Zachary4672/GRO400H26-Saltimbanques/README.md

# Saltimbanques
bras robotique

La documentation est disponible dans les dossiers correspondant
