Zachary4672/GRO400H26-Saltimbanques/CAD/Decoupe/Base rotative - Boîte Side 2.dxf

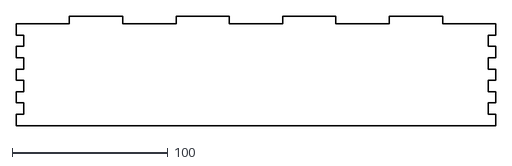
[picture p1: CAD file, 2026-04-19]
CAD/Decoupe/Base rotative - Boîte Side 2.dxf
308.0 x 70.0
