Zachary4672/GRO400H26-Saltimbanques/CAD/Impressions/J1.3mf

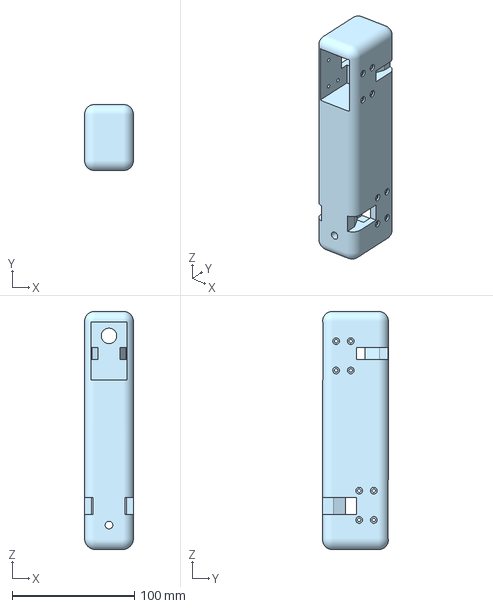
[picture p2: CAD file, 2026-04-19]
CAD/Impressions/J1.3mf
40.0 x 54.0 x 195.0 mm
