Zachary4672/GRO400H26-Saltimbanques/CAD/Pot de pillules - Part 1.step

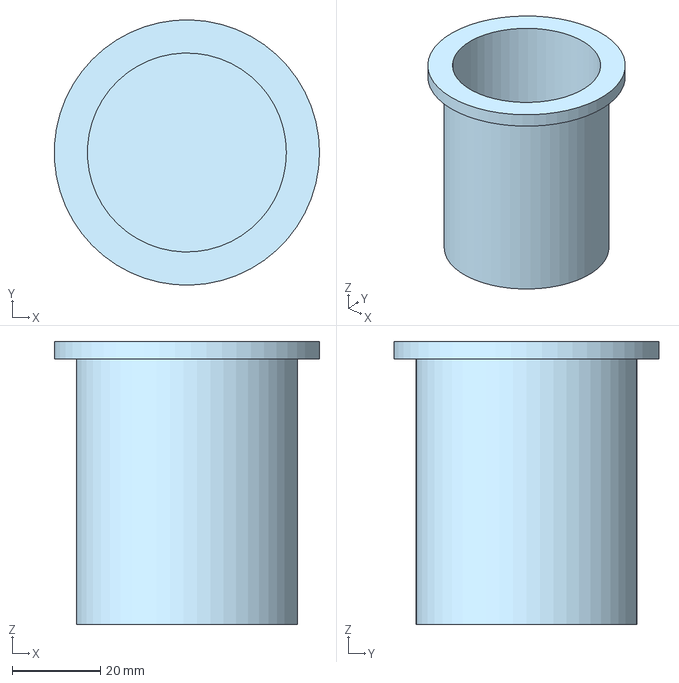
[picture p3: CAD file, 2026-04-19]
CAD/Pot de pillules - Part 1.step
59.9 x 60.0 x 64.0 mm
