Zachary4672/GRO400H26-Saltimbanques/CAD/Base rotative - Boite Top.step

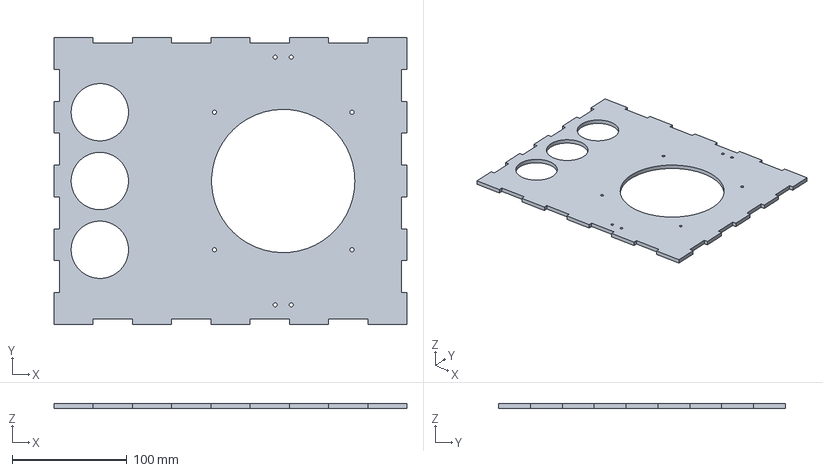
[picture p4: CAD file, 2026-04-19]
CAD/Base rotative - Boite Top.step
308.0 x 250.0 x 4.76 mm
