Zachary4672/GRO400H26-Saltimbanques/CAD/Decoupe/Base rotative - Boîte Side 1.dxf

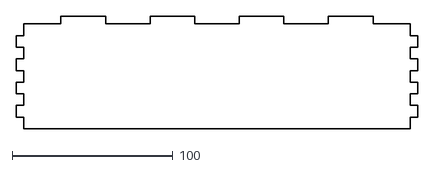
[picture p5: CAD file, 2026-04-19]
CAD/Decoupe/Base rotative - Boîte Side 1.dxf
250.0 x 70.0
