Zachary4672/GRO400H26-Saltimbanques/CAD/Axe Passif - Barre 1.step

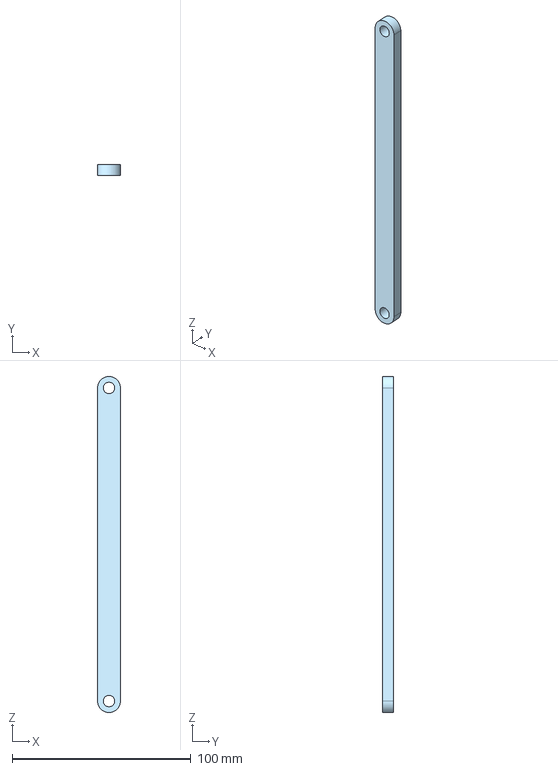
[picture p6: CAD file, 2026-04-19]
CAD/Axe Passif - Barre 1.step
12.8 x 6.00 x 187.8 mm
