Zachary4672/GRO400H26-Saltimbanques/CAD/Decoupe/Base rotative - Boite Top.dxf

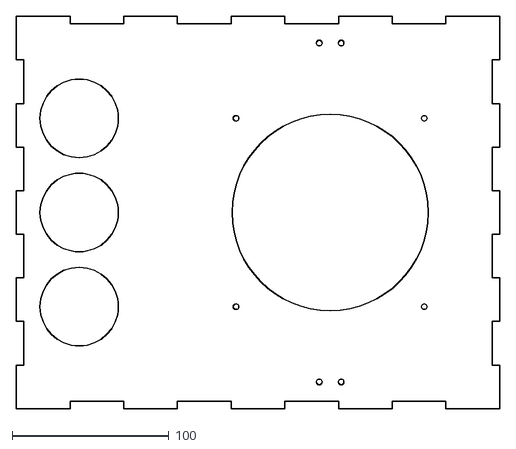
[picture p7: CAD file, 2026-04-19]
CAD/Decoupe/Base rotative - Boite Top.dxf
308.0 x 250.0
