Zachary4672/GRO400H26-Saltimbanques/CAD/Impressions/Poignet - Part 1.3mf

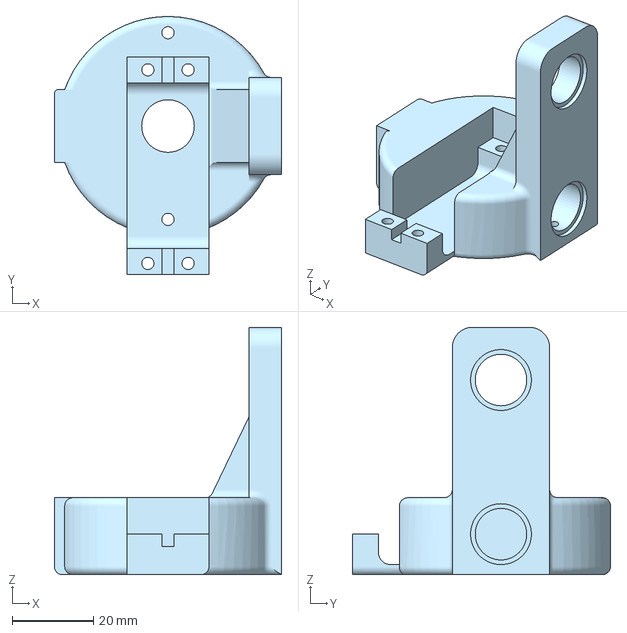
[picture p8: CAD file, 2026-04-19]
CAD/Impressions/Poignet - Part 1.3mf
56.0 x 63.6 x 61.0 mm
