Zachary4672/GRO400H26-Saltimbanques/CAD/Decoupe/Base rotative - Boîte Side 3.dxf

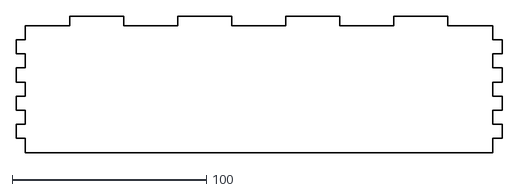
[picture p9: CAD file, 2026-04-19]
CAD/Decoupe/Base rotative - Boîte Side 3.dxf
250.0 x 70.0
