Zachary4672/GRO400H26-Saltimbanques/CAD/Impressions/Axe Passif - Barre 2.3mf

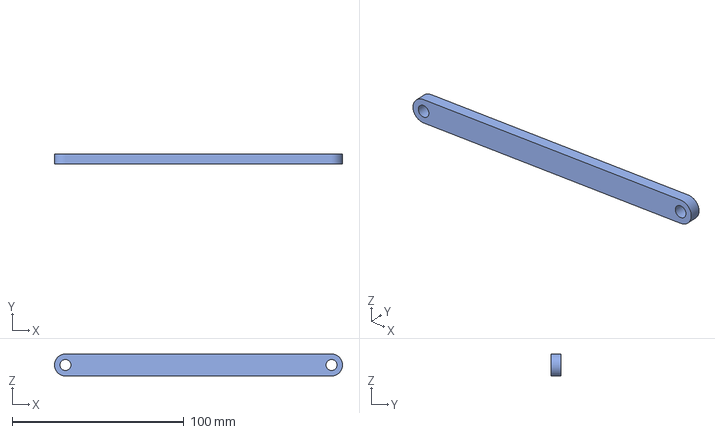
[picture p10: CAD file, 2026-04-19]
CAD/Impressions/Axe Passif - Barre 2.3mf
167.8 x 6.00 x 12.8 mm
