Zachary4672/GRO400H26-Saltimbanques/CAD/Nouveau gripper - base_pince2.step

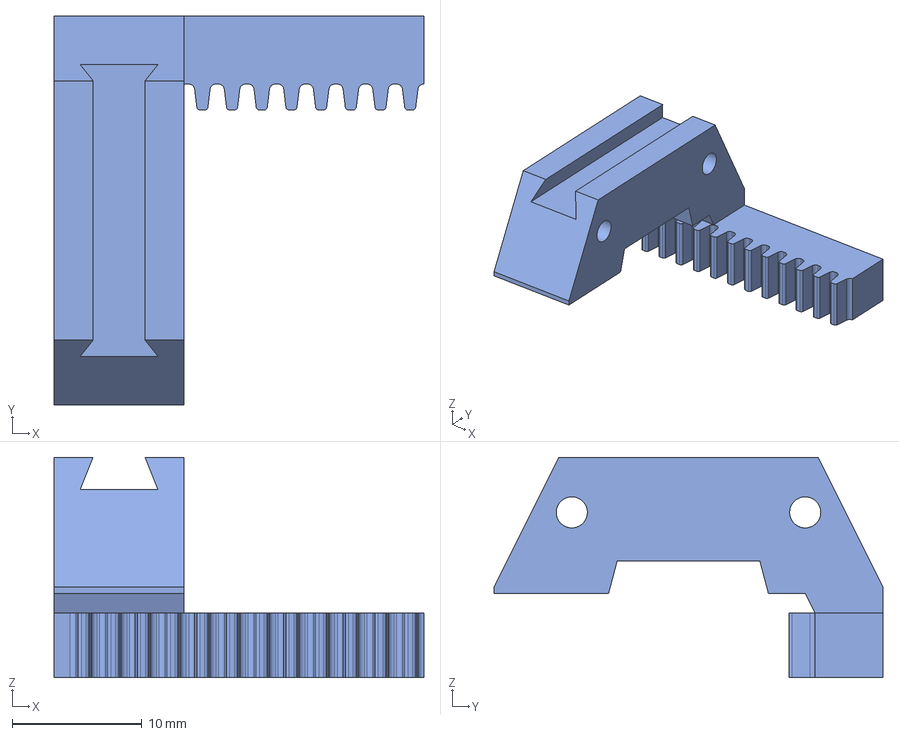
[picture p11: CAD file, 2026-04-19]
CAD/Nouveau gripper - base_pince2.step
28.5 x 30.0 x 17.0 mm
