Zachary4672/GRO400H26-Saltimbanques/CAD/Axe Passif - Triangle.step

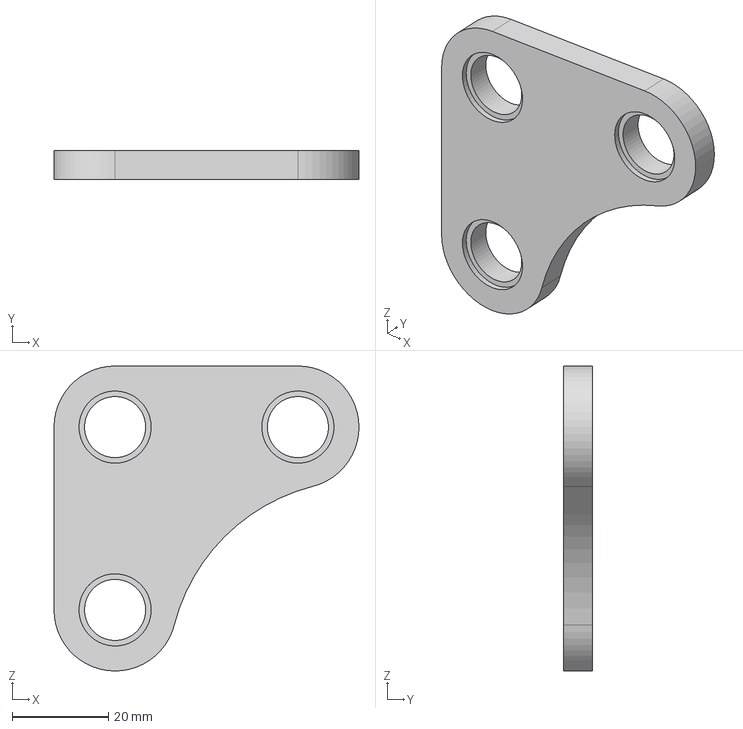
[picture p12: CAD file, 2026-04-19]
CAD/Axe Passif - Triangle.step
63.4 x 6.00 x 63.4 mm
