Zachary4672/GRO400H26-Saltimbanques/CAD/Decoupe/Base rotative - Boîte Side 4.dxf

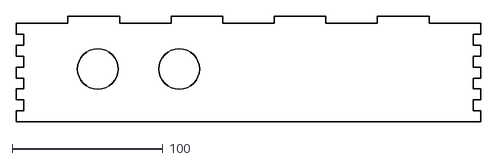
[picture p13: CAD file, 2026-04-19]
CAD/Decoupe/Base rotative - Boîte Side 4.dxf
308.0 x 70.0
