Zachary4672/GRO400H26-Saltimbanques/CAD/Impressions/Base rotative - Anneau Extérieur.3mf

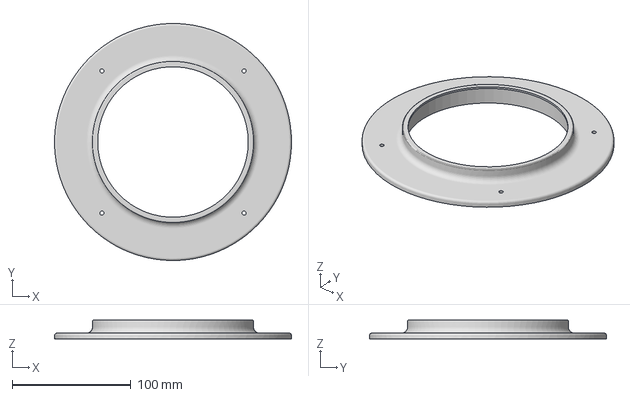
[picture p14: CAD file, 2026-04-19]
CAD/Impressions/Base rotative - Anneau Extérieur.3mf
200.0 x 200.0 x 16.0 mm
