Zachary4672/GRO400H26-Saltimbanques/CAD/Impressions/Nouveau gripper - Part 7.3mf

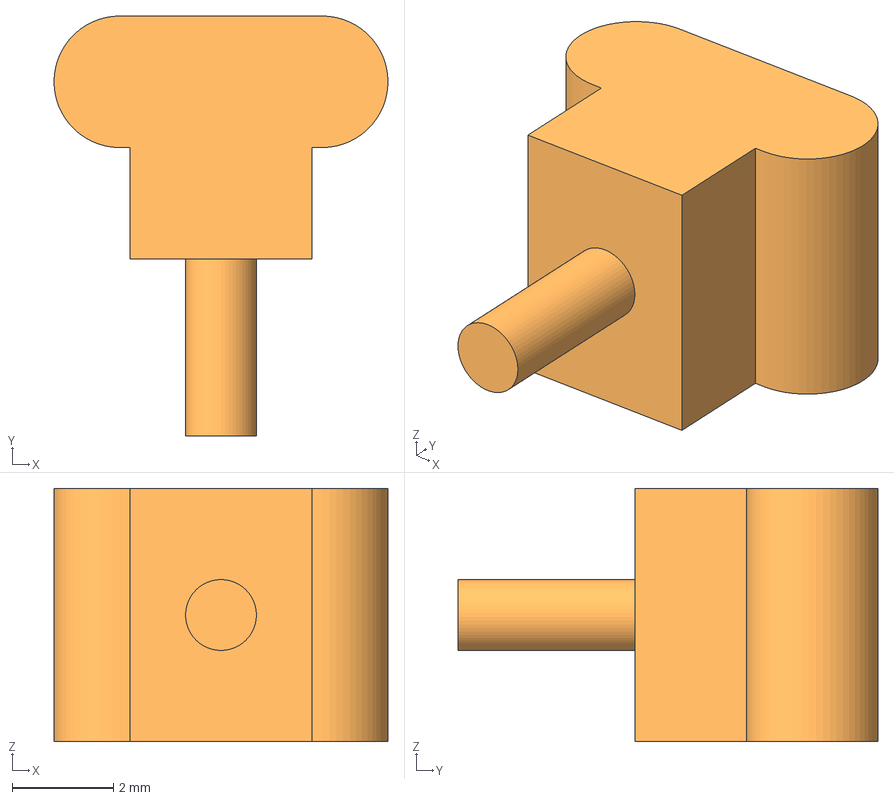
[picture p15: CAD file, 2026-04-19]
CAD/Impressions/Nouveau gripper - Part 7.3mf
6.60 x 8.30 x 5.00 mm
