Zachary4672/GRO400H26-Saltimbanques/CAD/Nouveau gripper - roue_vide.step

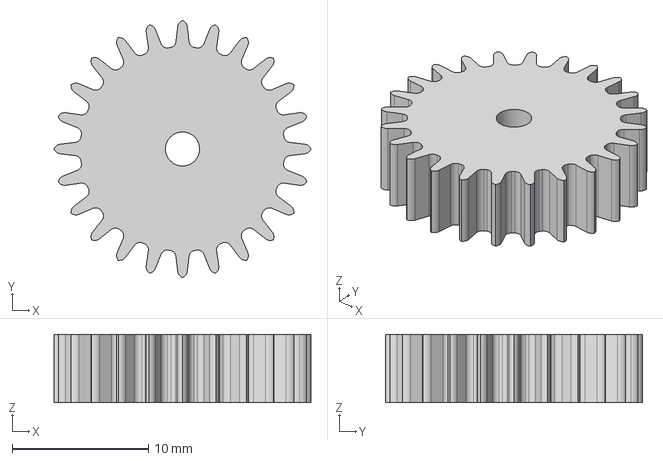
[picture p16: CAD file, 2026-04-19]
CAD/Nouveau gripper - roue_vide.step
18.9 x 18.9 x 5.00 mm
