Zachary4672/GRO400H26-Saltimbanques/CAD/attache.step

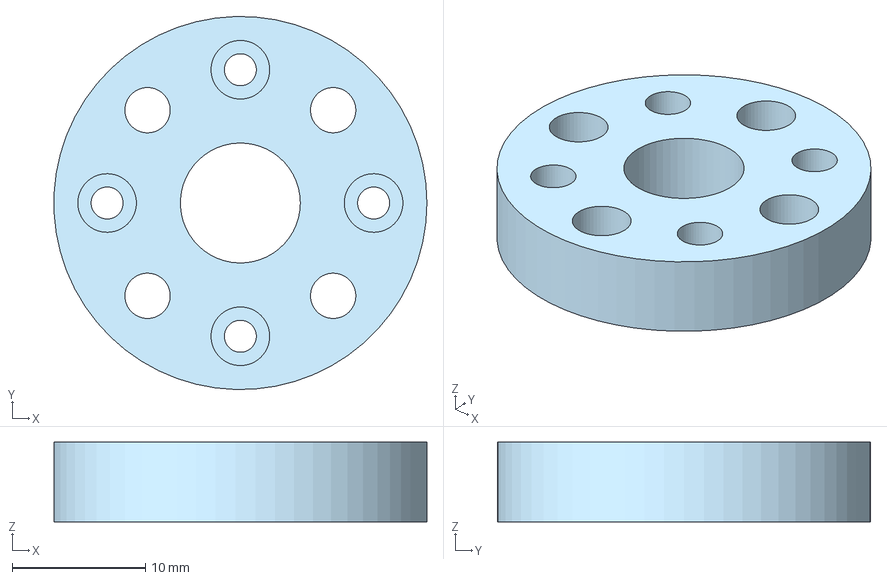
[picture p17: CAD file, 2026-04-19]
CAD/attache.step
28.0 x 28.0 x 6.00 mm
