Zachary4672/GRO400H26-Saltimbanques/CAD/Impressions/Nouveau gripper - fixation roue.3mf

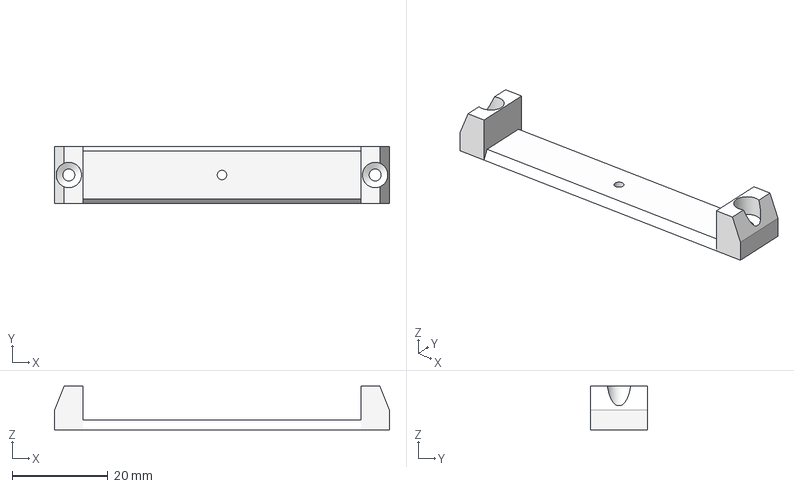
[picture p18: CAD file, 2026-04-19]
CAD/Impressions/Nouveau gripper - fixation roue.3mf
70.0 x 12.0 x 9.10 mm
