Zachary4672/GRO400H26-Saltimbanques/CAD/Impressions/Base rotative - Joint 0.3mf

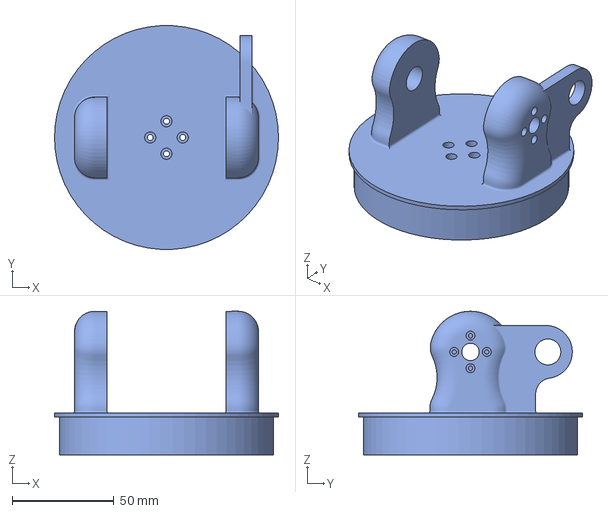
[picture p19: CAD file, 2026-04-19]
CAD/Impressions/Base rotative - Joint 0.3mf
110.0 x 109.8 x 70.5 mm
