Zachary4672/GRO400H26-Saltimbanques/CAD/Nouveau gripper - Part 9.step

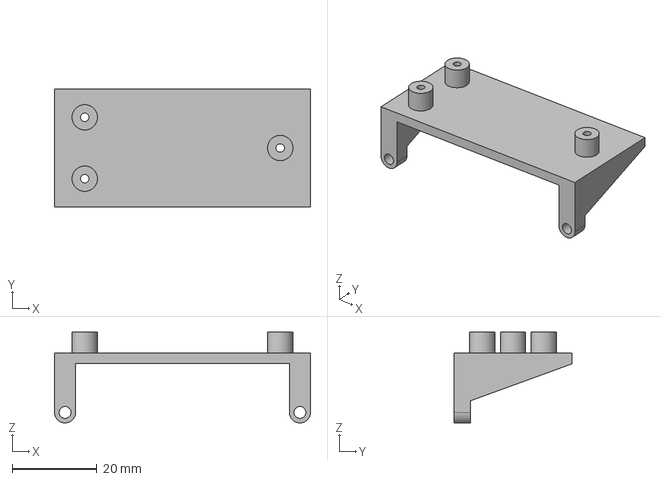
[picture p20: CAD file, 2026-04-19]
CAD/Nouveau gripper - Part 9.step
60.5 x 28.0 x 21.5 mm
