Zachary4672/GRO400H26-Saltimbanques/CAD/Impressions/Poignet - Part 2.3mf

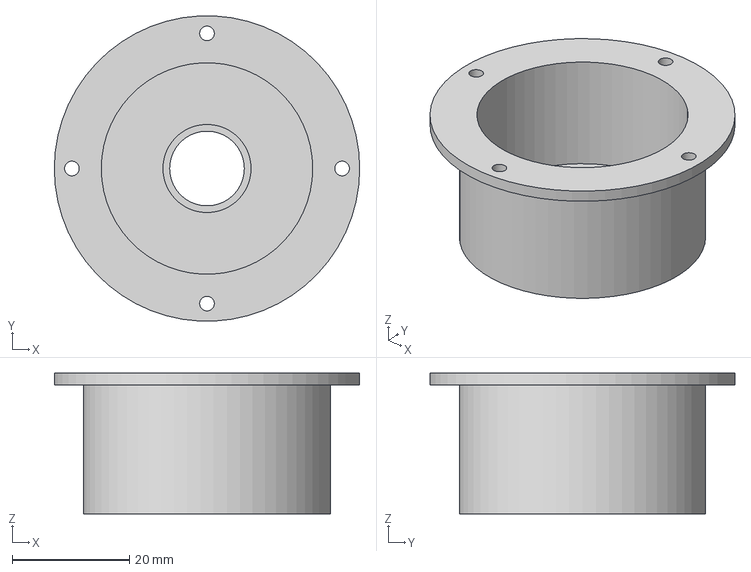
[picture p21: CAD file, 2026-04-19]
CAD/Impressions/Poignet - Part 2.3mf
52.0 x 51.9 x 24.0 mm
