Zachary4672/GRO400H26-Saltimbanques/CAD/Base rotative - Support Moteur.step

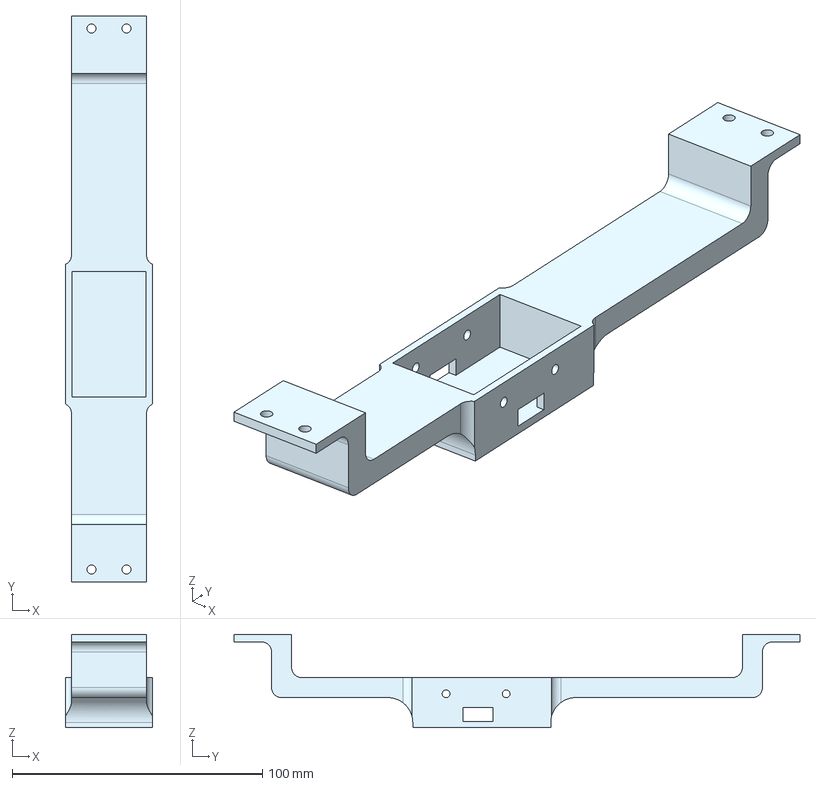
[picture p23: CAD file, 2026-04-19]
CAD/Base rotative - Support Moteur.step
34.6 x 226.0 x 37.2 mm
