Zachary4672/GRO400H26-Saltimbanques/CAD/Impressions/Nouveau gripper - base_pince1.3mf

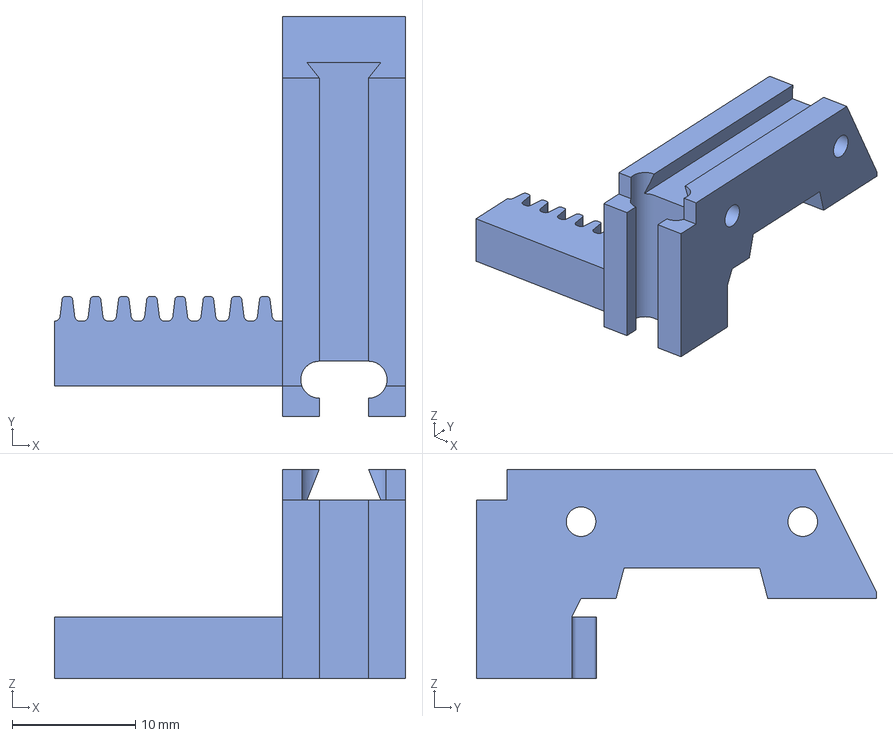
[picture p24: CAD file, 2026-04-19]
CAD/Impressions/Nouveau gripper - base_pince1.3mf
28.5 x 32.5 x 17.0 mm
