Zachary4672/GRO400H26-Saltimbanques/CAD/Impressions/Nouveau gripper - base_pince2.3mf

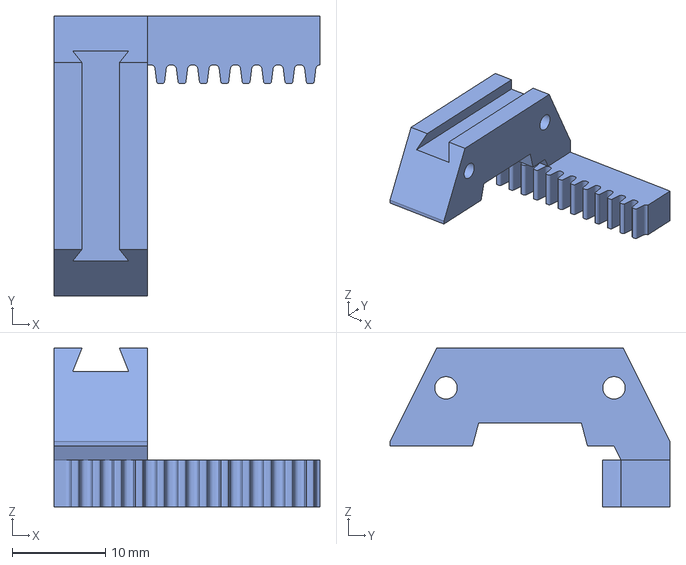
[picture p25: CAD file, 2026-04-19]
CAD/Impressions/Nouveau gripper - base_pince2.3mf
28.5 x 30.0 x 17.0 mm
