Zachary4672/GRO400H26-Saltimbanques/CAD/Impressions/Nouveau gripper - boîte 1.3mf

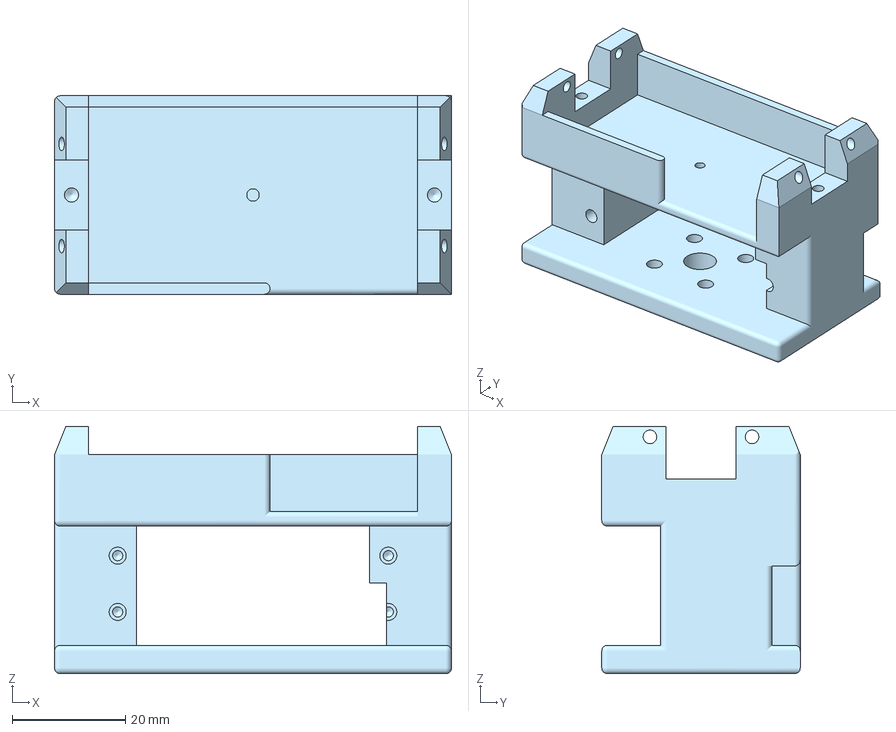
[picture p26: CAD file, 2026-04-19]
CAD/Impressions/Nouveau gripper - boîte 1.3mf
70.0 x 35.0 x 43.6 mm
