Zachary4672/GRO400H26-Saltimbanques/CAD/Base rotative - Boîte Side 3.step

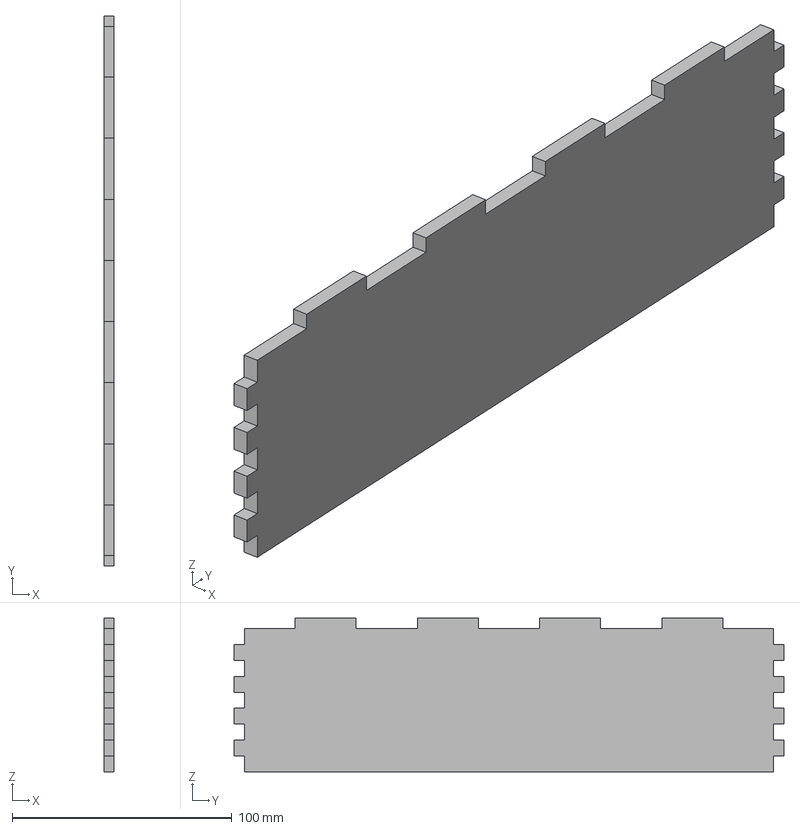
[picture p27: CAD file, 2026-04-19]
CAD/Base rotative - Boîte Side 3.step
4.76 x 250.0 x 70.0 mm
