Zachary4672/GRO400H26-Saltimbanques/CAD/Impressions/J2.3mf

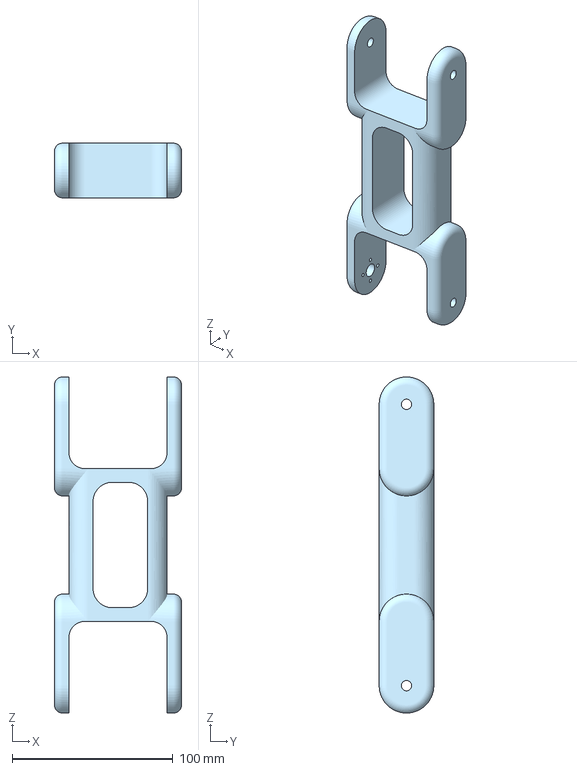
[picture p28: CAD file, 2026-04-19]
CAD/Impressions/J2.3mf
79.0 x 34.0 x 209.0 mm
