Zachary4672/GRO400H26-Saltimbanques/CAD/Impressions/Nouveau gripper - Pince_1.3mf

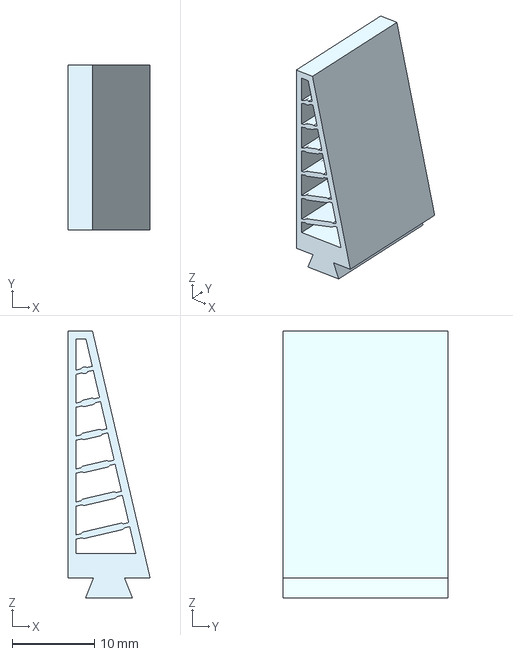
[picture p29: CAD file, 2026-04-19]
CAD/Impressions/Nouveau gripper - Pince_1.3mf
10.0 x 20.0 x 32.4 mm
