Zachary4672/GRO400H26-Saltimbanques/CAD/Base rotative - Boîte Side 2.step

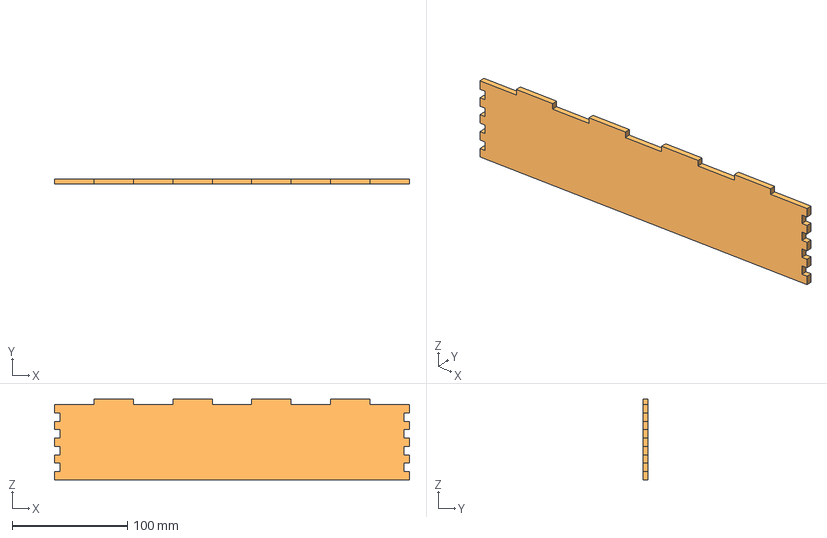
[picture p30: CAD file, 2026-04-19]
CAD/Base rotative - Boîte Side 2.step
308.0 x 4.76 x 70.0 mm
