Zachary4672/GRO400H26-Saltimbanques/CAD/Nouveau gripper - base_pince1.step

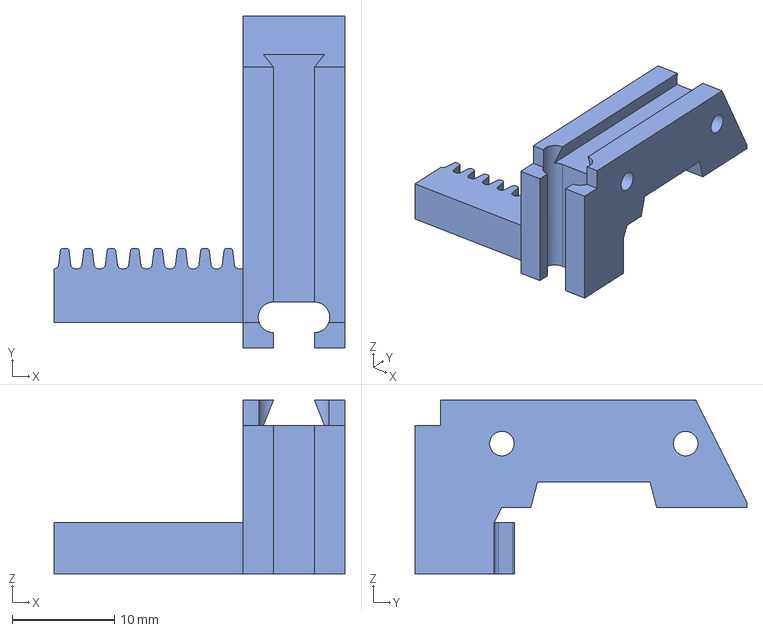
[picture p31: CAD file, 2026-04-19]
CAD/Nouveau gripper - base_pince1.step
28.5 x 32.5 x 17.0 mm
