Zachary4672/GRO400H26-Saltimbanques/CAD/Base rotative - Bearing.step

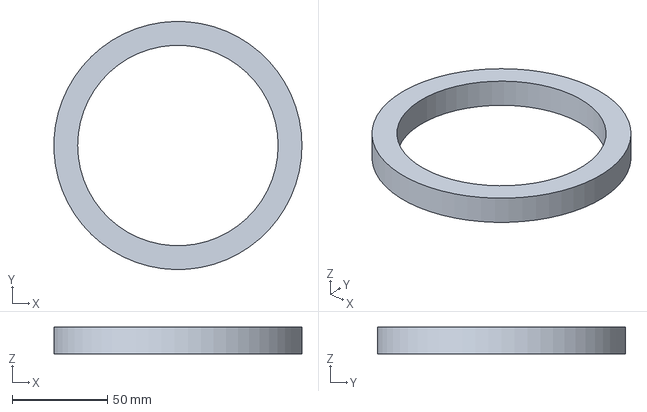
[picture p32: CAD file, 2026-04-19]
CAD/Base rotative - Bearing.step
129.9 x 130.0 x 14.0 mm
