Zachary4672/GRO400H26-Saltimbanques/CAD/Nouveau gripper - Roue dentée.step

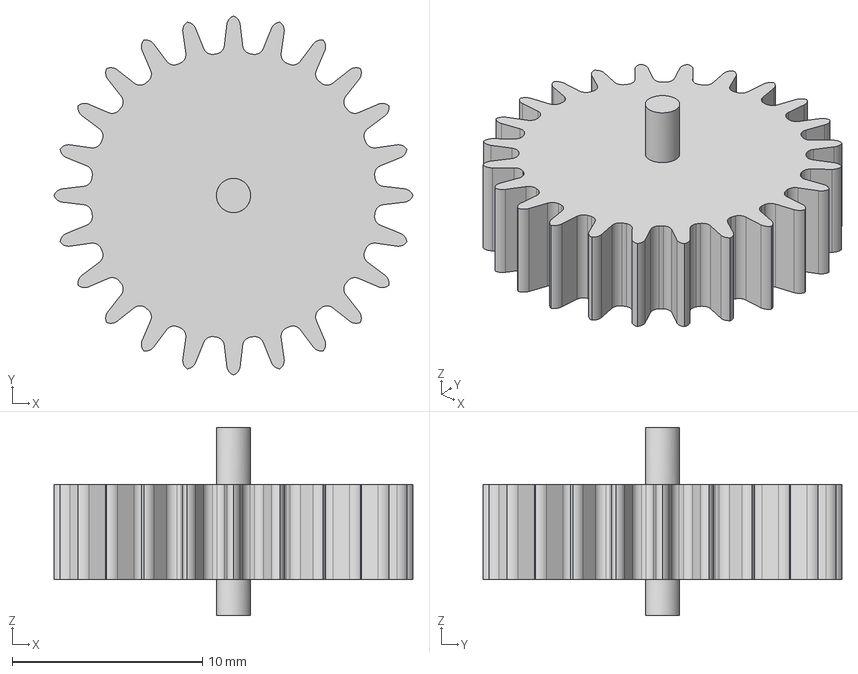
[picture p33: CAD file, 2026-04-19]
CAD/Nouveau gripper - Roue dentée.step
18.9 x 18.9 x 9.90 mm
