Zachary4672/GRO400H26-Saltimbanques/(list of files, cad)

Other CAD files:
CAD/Impressions/Pot de pillules.3mf
CAD/Axe Passif - Barre 2.step
CAD/Impressions/Nouveau gripper - roue_vide.3mf
CAD/Impressions/Axe Passif - Triangle.3mf
CAD/Nouveau gripper - Part 7.step
CAD/Base rotative - Anneau Extérieur.step
CAD/Impressions/attache - Part 1.3mf
CAD/Base rotative - Joint 0.step
CAD/Nouveau gripper - fixation roue.step
CAD/Nouveau gripper - boîte 1.step
CAD/Nouveau gripper - Pince_1.step
CAD/J2.step
CAD/Poignet - Part 1.step
CAD/J1 - Part 1.step
CAD/Poignet - Part 2.step
CAD/Base rotative - Boîte Side 1.step
