Zachary4672/GRO400H26-Saltimbanques/HMI_INSTALL/README

La documentation est disponible dans l'onglet "Wiki" de ce github.
