Zachary4672/GRO400H26-Saltimbanques/(commit log)

2026-02-18 code moteur organiser plus le code pour contrôler le gripper
2026-02-20 petit changement pour les cas limite
2026-02-21 Add files via upload
    model de CV entrainé avec des Jellybean. Détecte encore certains faux positif lorsque l'image est flou, ou que l'objet est rond est saturé.
2026-02-23 Ajout des positions de JB
2026-02-24 sortie des positions
2026-04-01 Code et nouveau fichier pour calibration avec un échéquier.
2026-04-01 proche de version final
2026-04-01 Calibration semble bonne. Implémentation de l'image calibrée dans le traitement d'image
2026-04-08 Cinematique corrigée (test à suivre)
    [Tests.py, bras_robot.py, donnees.py, main.py]
2026-04-08 Problème de logique
2026-04-09 Modification du main pour les tests de demain
2026-04-09 Create CAD
    ddd
2026-04-09 Correction des angles
2026-04-09 fichier de calibration de la caméra
2026-04-09 changement de nom
2026-04-09 modification cinématique reste modifier (modifier des commentaires)
2026-04-11 Cleaning du code main.py et ajout du squelette pour l'ajout de la partie de contrôle venant du HMI
2026-04-12 pret pour le premier test camera et robot
2026-04-15 Revert "débug encore"
    This reverts commit e6407ce1372f0752042352ce09e92b26517165d9.
    [bras_robot.py, donnees.py, main.py]
2026-04-15 Commit
    commit
    [arduino_zero.cfg]
2026-04-16 nouvelle calibration
2026-04-16 correction calibration
2026-04-19 Refactor robot arm functions and improve comments
2026-04-19 Modif Mathis
    [Axe Passif - Barre 1.step, Axe Passif - Barre 2.3mf, Axe Passif - Barre 2.step, Axe Passif - Triangle.3mf, Axe Passif - Triangle.step, Base rotative - Anneau Extérieur.3mf, Base rotative - Anneau Extérieur.step, Base rotative - Bearing.step]
